oribotic/oribokit/boards/oribokit-1.1.png

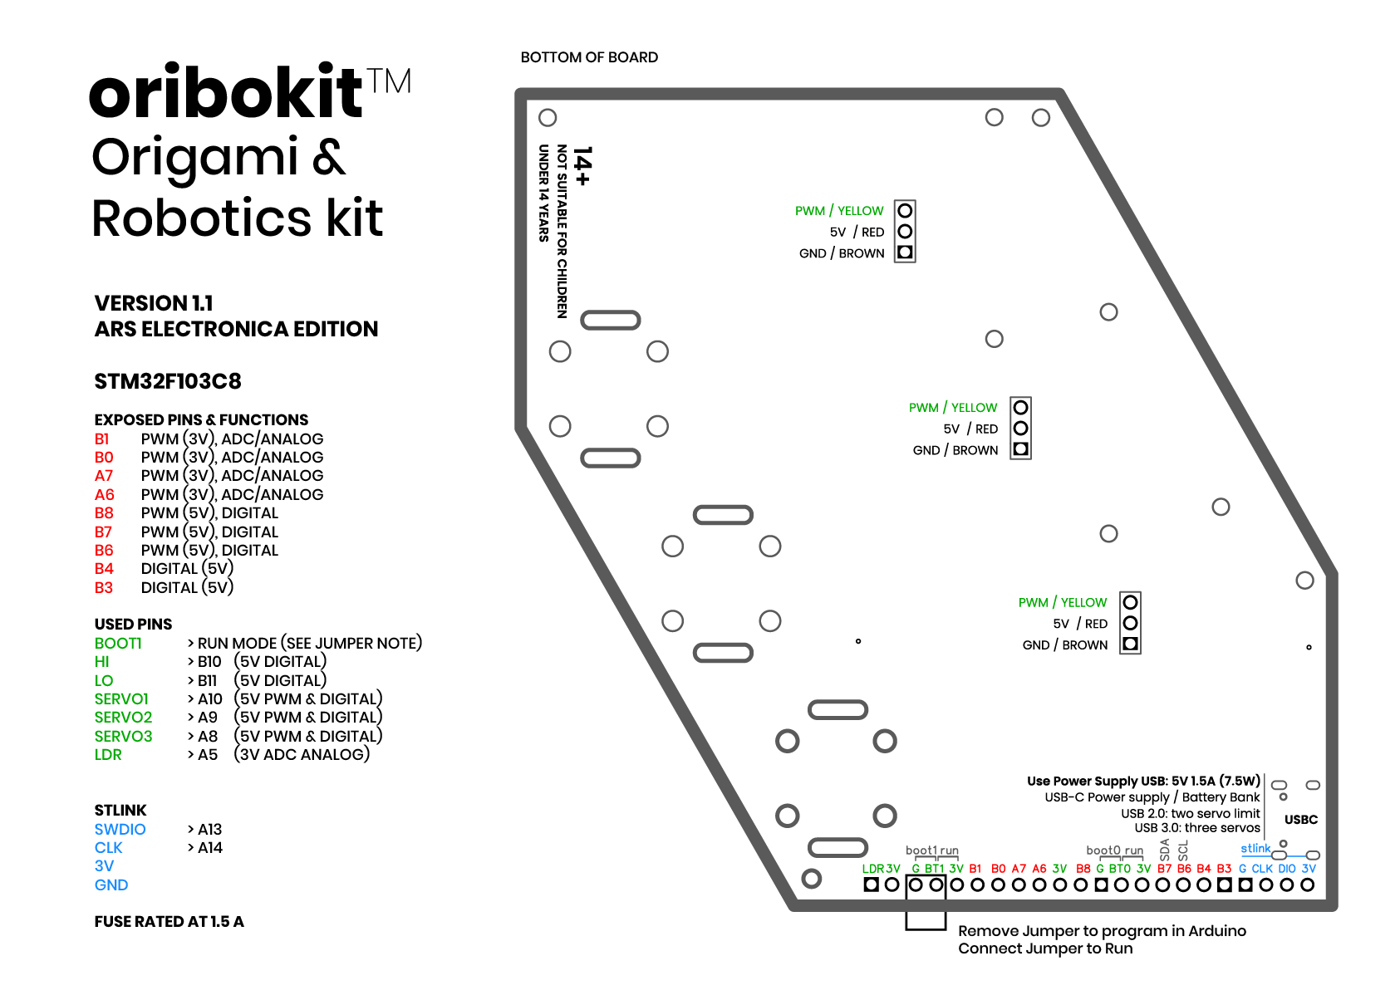
boards/oribokit-1.1.png
