oribotic/oribokit/boards/oribokit-board-1.1.jpg

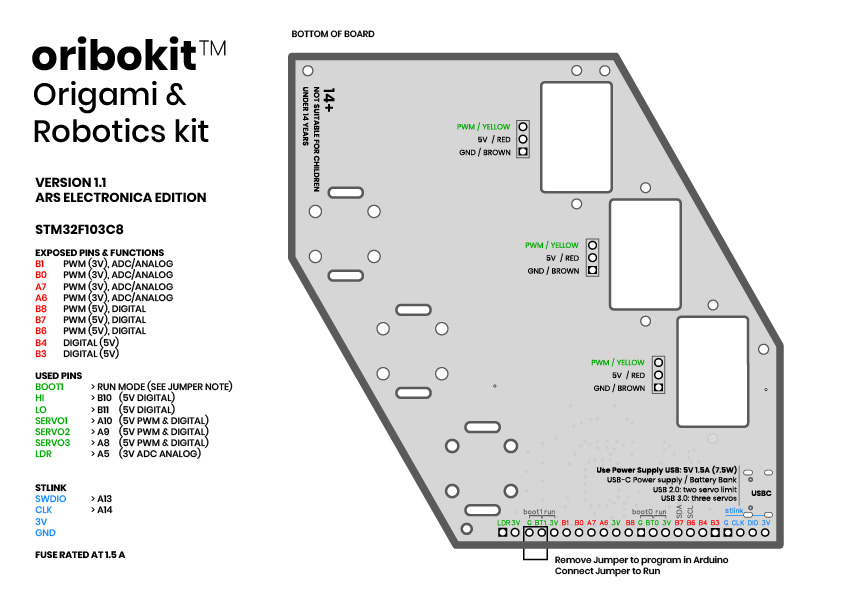
boards/oribokit-board-1.1.jpg
