oribotic/oribokit/boards/oribokit-schematic-v1.6.pdf

## POWER

5V

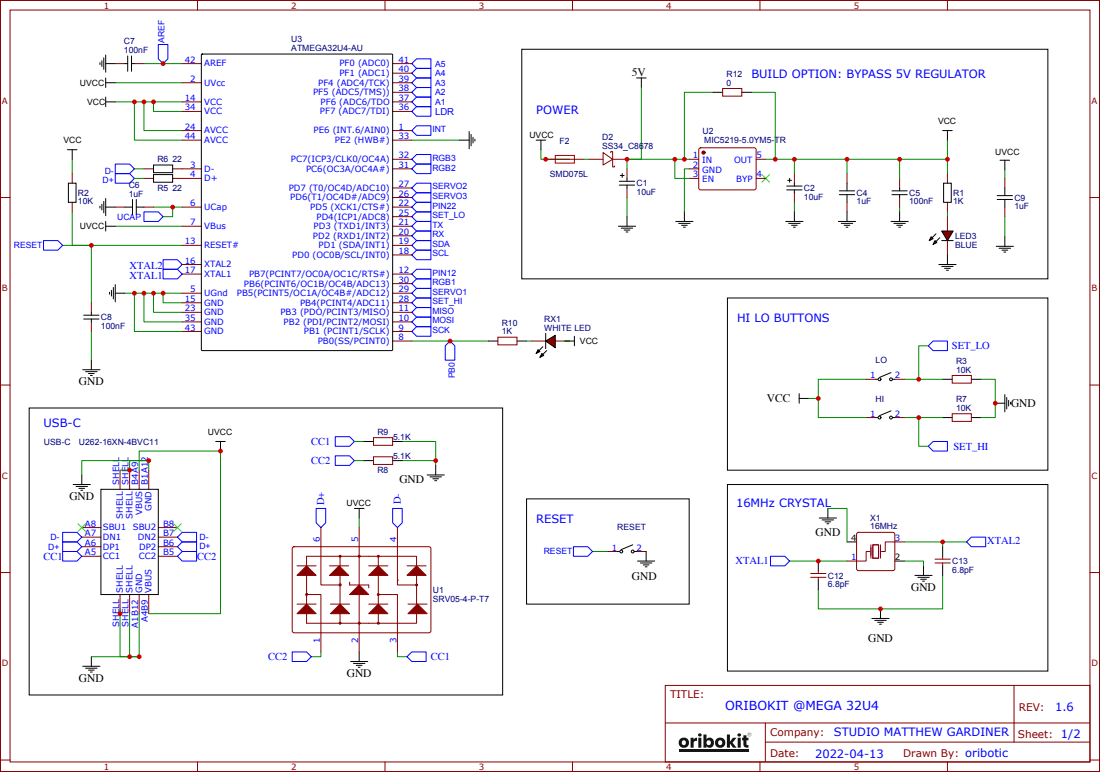
[picture p7: page 1]

PB7(PCINT7/OC0A/OC1C/RTS#) 12
PB0(SS/PCINT0) 8 PB1 (PCINT1/SCLK) 9 PB2 (PDI/PCINT2/MOSI) 10 PB3 (PDO/PCINT3/MISO) 11 PB4(PCINT4/ADC11) 28 PB5(PCINT5/OC1A/OC4B#/ADC12) 29 PB6(PCINT6/OC1B/OC4B/ADC13) 30

SHELL SHELL SHELL SHELL
GND

Company: STUDIO MATTHEW GARDINER
Date: 2022-04-13

## SERVO CONNECTORS

# GND

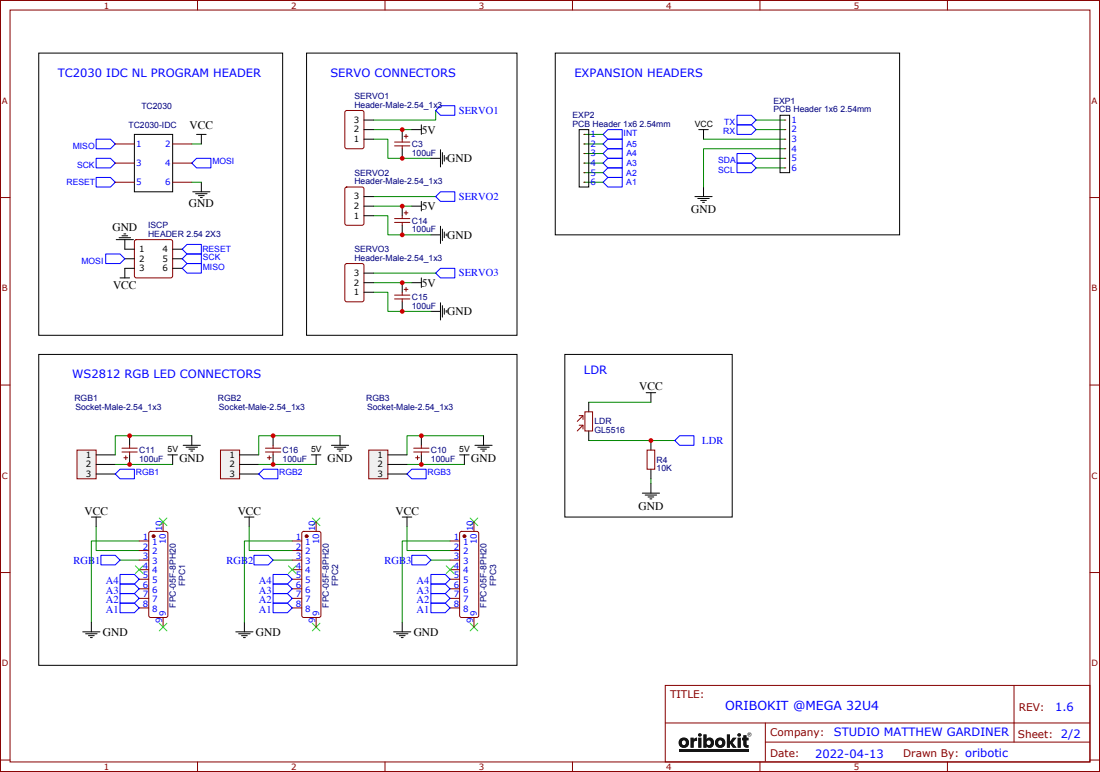
[picture p8: page 2]

TC2030 IDC NL PROGRAM HEADER

## POWER

5V

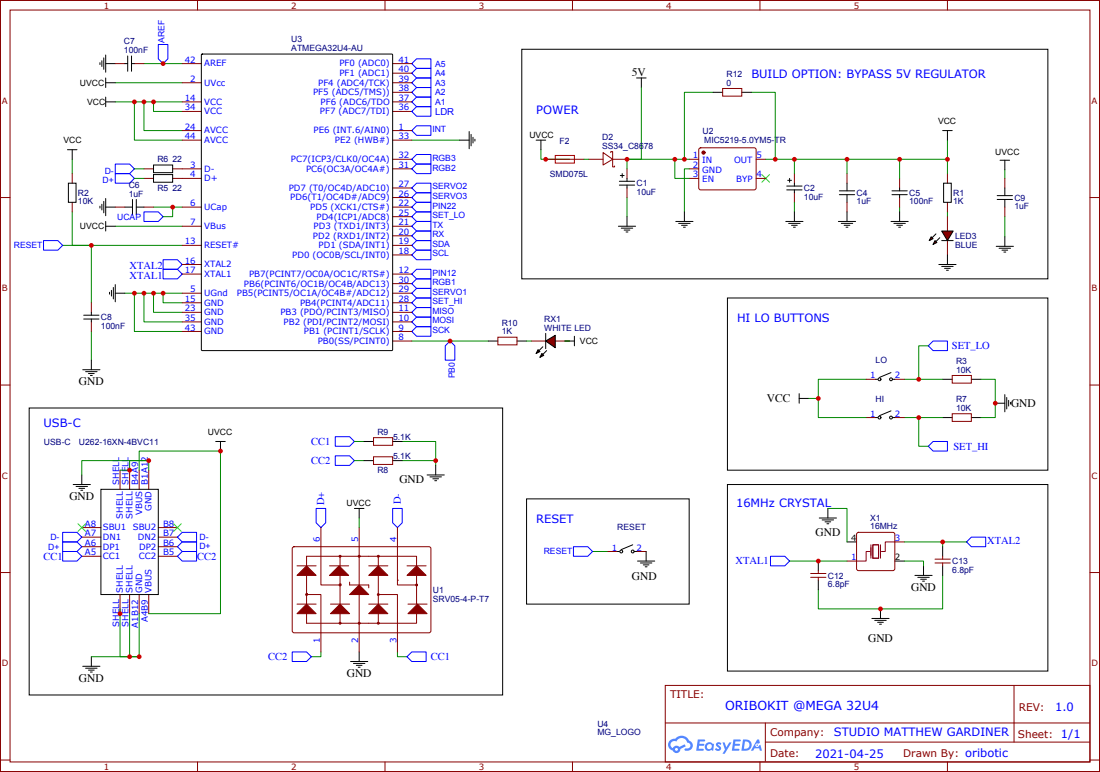
[picture p9: page 3]
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

SHELL SHELL SHELL SHELL
GND

## SERVO CONNECTORS

# GND

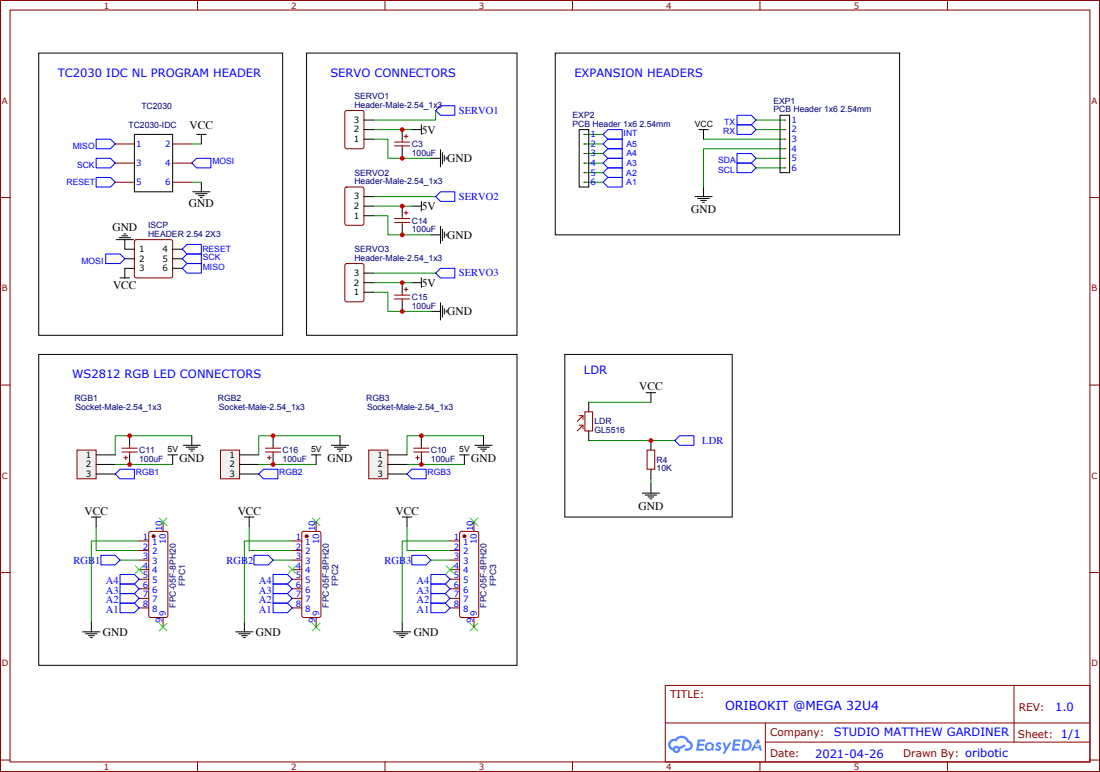
[picture p10: page 4]

TC2030 IDC NL PROGRAM HEADER
