oribotic/oribokit/boards/oribokit-1.0.pdf

# Origami & Robotics kit

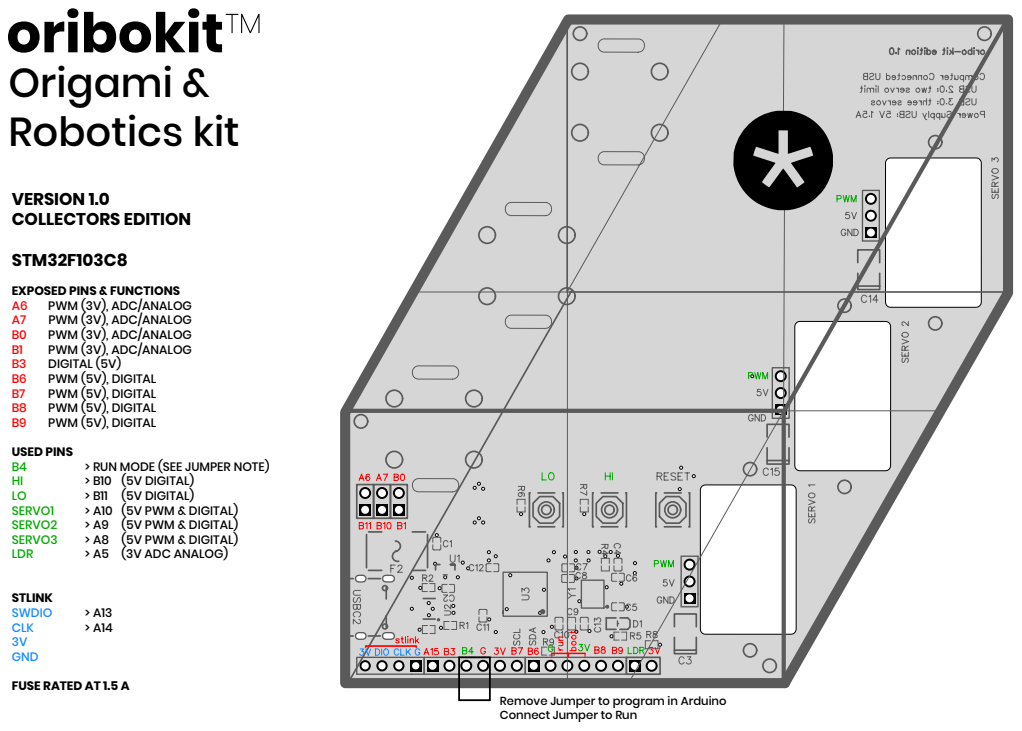
[picture p11: page 1]
oribokit™; PWM (3V), ADC/ANALOG; > RUN MODE (SEE JUMPER NOTE); > B10 (5V DIGITAL); > B11 (5V DIGITAL); SERVO1; > A10 (5V PWM & DIGITAL); SERVO2; > A9 (5V PWM & DIGITAL); SERVO3; > A8 (5V PWM & DIGITAL); LDR; > A5 (3V ADC ANALOG); STLINK; SWDIO; CLK; 3V GND FUSE RATED AT 1.5 A

VERSION 1.0
COLLECTORS EDITION
STM32F103C8
EXPOSED PINS & FUNCTIONS
A6 PWM (3V), ADC/ANALOG
A7 PWM (3V), ADC/ANALOG
B0 PWM (3V), ADC/ANALOG
B3 DIGITAL (5V)
B6 PWM (5V), DIGITAL
B7 PWM (5V), DIGITAL
B8 PWM (5V), DIGITAL
B9 PWM (5V), DIGITAL
USED PINS

Remove Jumper to program in Arduino
Connect Jumper to Run
