oribotic/oribokit/boards/oribokit-boards.pdf

# Origami & Robotics kit

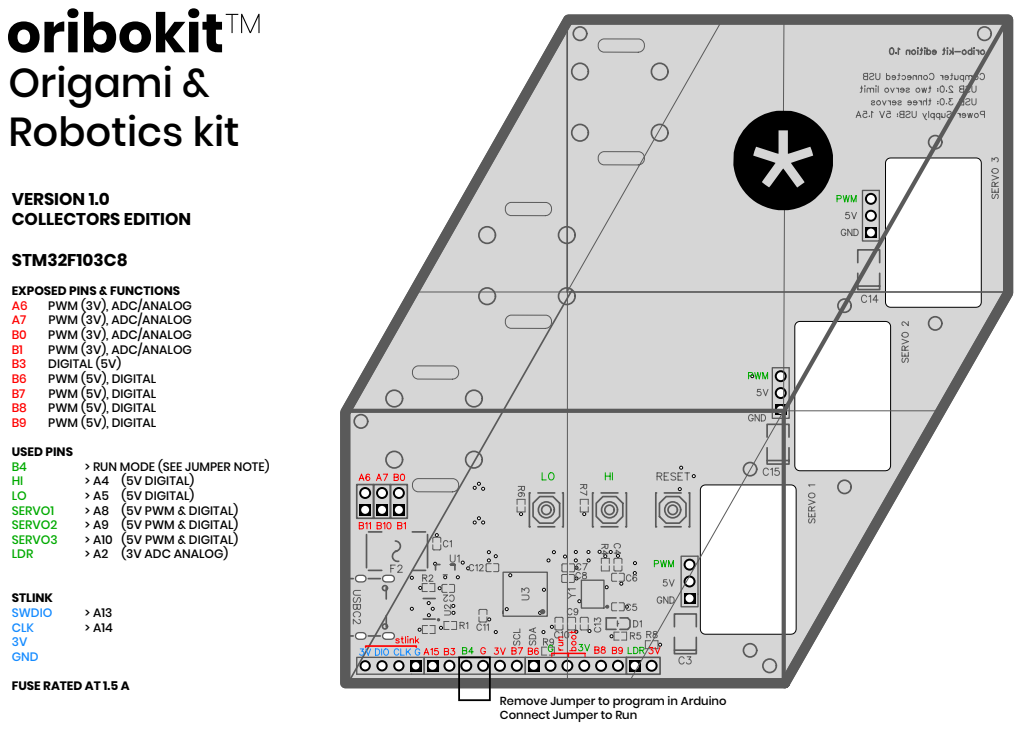
[picture p15: page 1]
oribokit™; PWM (3V), ADC/ANALOG; > RUN MODE (SEE JUMPER NOTE); > A4 (5V DIGITAL); > A5 (5V DIGITAL); SERVO1; > A8 (5V PWM & DIGITAL); SERVO2; > A9 (5V PWM & DIGITAL); SERVO3; > A10 (5V PWM & DIGITAL); LDR; > A2 (3V ADC ANALOG); STLINK; SWDIO; CLK; 3V GND FUSE RATED AT 1.5 A

VERSION 1.0
COLLECTORS EDITION
STM32F103C8
EXPOSED PINS & FUNCTIONS
A6 PWM (3V), ADC/ANALOG
A7 PWM (3V), ADC/ANALOG
B0 PWM (3V), ADC/ANALOG
B3 DIGITAL (5V)
B6 PWM (5V), DIGITAL
B7 PWM (5V), DIGITAL
B8 PWM (5V), DIGITAL
B9 PWM (5V), DIGITAL
USED PINS

Remove Jumper to program in Arduino
Connect Jumper to Run

# Origami & Robotics kit

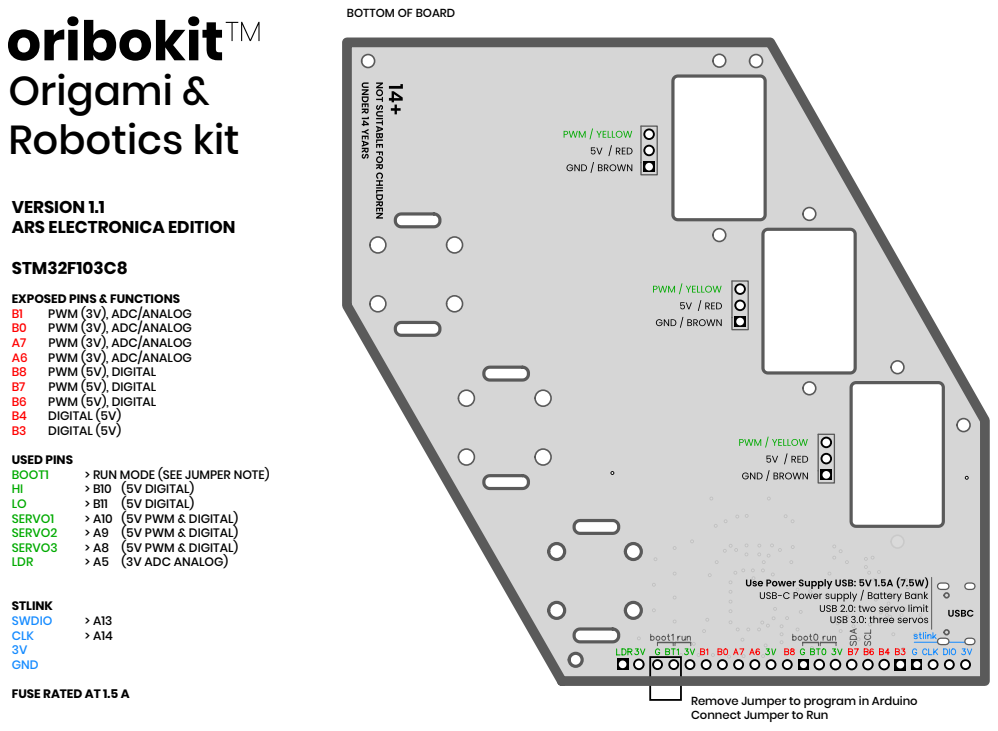
[picture p16: page 2]
oribokit; PWM (3V), ADC/ANALOG; BOOT1; > RUN MODE (SEE JUMPER NOTE); > B10 (5V DIGITAL); > B11 (5V DIGITAL); SERVO1; > A10 (5V PWM & DIGITAL); SERVO2; > A9 (5V PWM & DIGITAL); SERVO3; > A8 (5V PWM & DIGITAL); LDR; > A5 (3V ADC ANALOG); STLINK; SWDIO; CLK; 3V GND; FUSE RATED AT 1.5 A; Remove Jumper to program in Arduino

BOTTOM OF BOARD

VERSION 1.1
ARS ELECTRONICA EDITION
STM32F103C8
EXPOSED PINS & FUNCTIONS
B0 PWM (3V), ADC/ANALOG
A7 PWM (3V), ADC/ANALOG
A6 PWM (3V), ADC/ANALOG
B8 PWM (5V), DIGITAL
B7 PWM (5V), DIGITAL
B6 PWM (5V), DIGITAL
B4 DIGITAL (5V)
B3 DIGITAL (5V)
USED PINS

Connect Jumper to Run
