oribotic/oribokit/(commit log)

2020-09-30 added boards information
    for programmers to use exposed pins
2022-02-03 New board versions added 1.4, 1.5, 1.6
2022-02-03 jpegs of new boards 1.4, 1.5, 1.6
2022-02-03 added new boards
2022-06-22 correction - servo pins were no labelled correctly
2022-06-22 oribokit schematic for version 1.6
2022-06-23 Create oribokit-LED-RGB
2023-08-29 osc update completed
    added: handlers for all variables, servo min/max, loopdelay
    added: eeprom storage of all modifiable variables
2025-01-23 added firmware for oribokit-mono-1.0 new board design, minor updates to pure data patches
